simon-nunez-aschenbrenner/bloom-mcu/doc/lora_activity_diagram.png

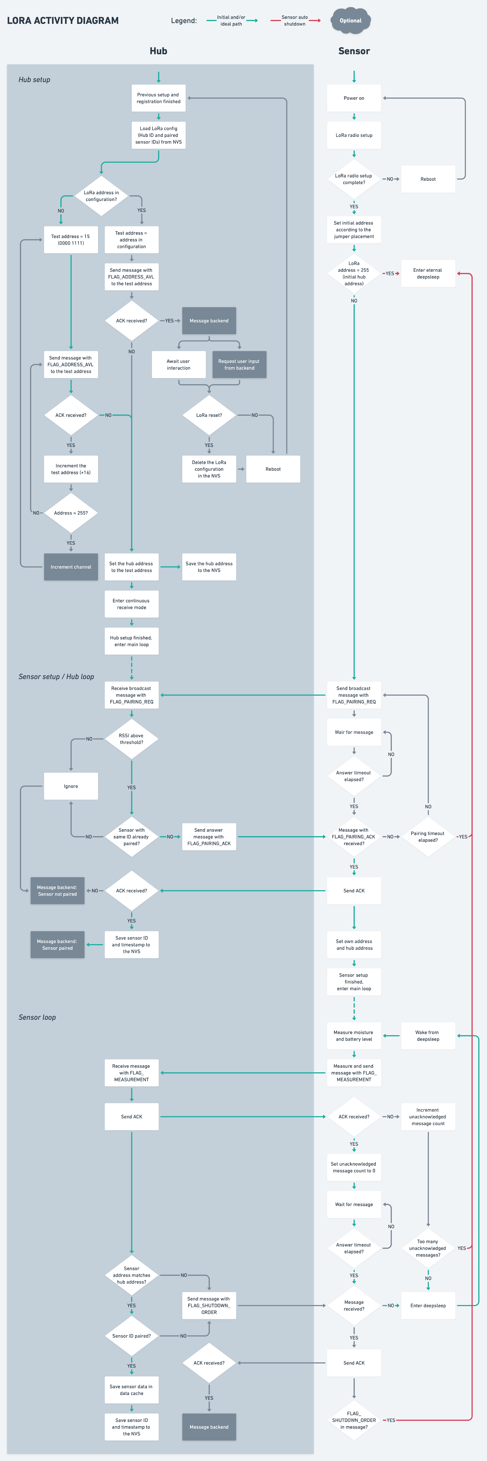
doc/lora_activity_diagram.png
