simon-nunez-aschenbrenner/bloom-mcu/doc/setup_activity_diagram.png

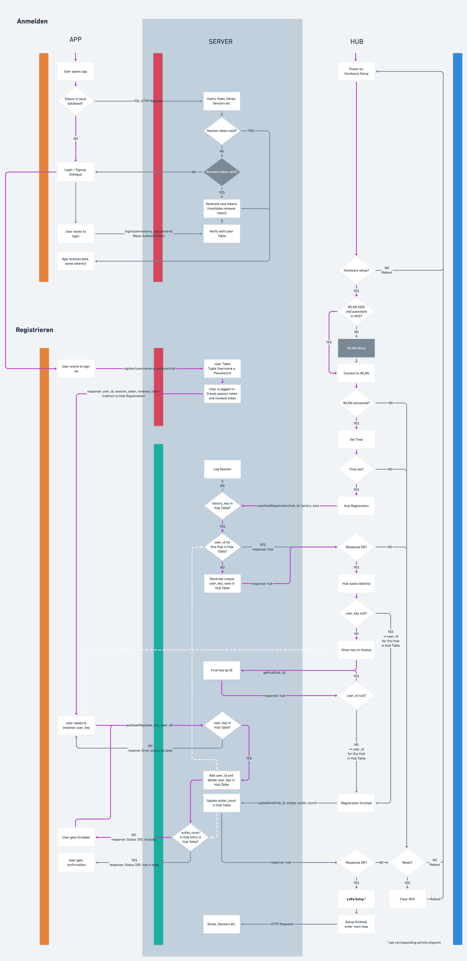
doc/setup_activity_diagram.png
